VoiD7965/Station_Meteo_pcb/Station_Meteo_pcb.kicad_pcb

## KiCad design Station_Meteo_pcb.kicad_pcb (2026-05-05)

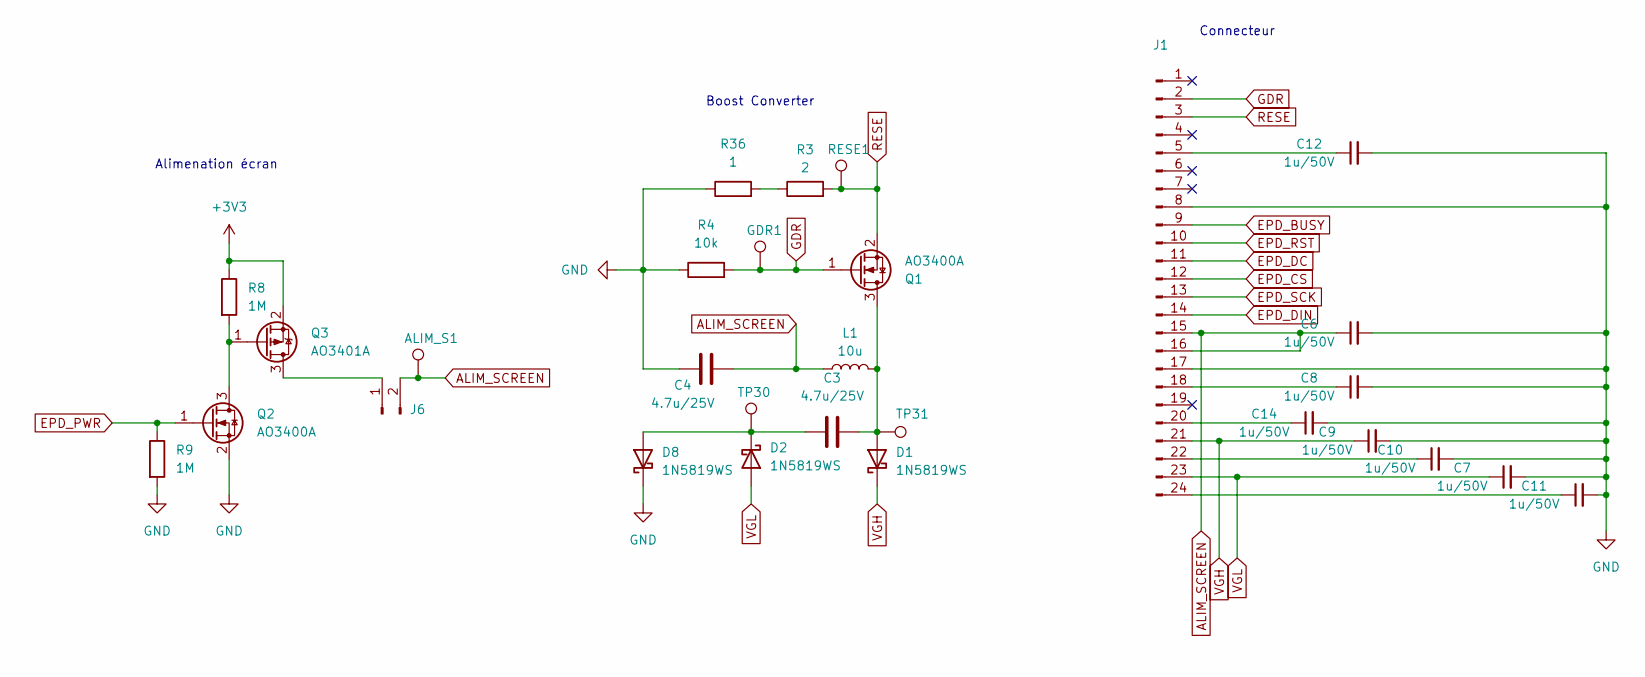
[picture p1: schematic Ecran.kicad_sch]

Parts:
ALIM_S1: TestPoint; TestPoint_Pad_D1.5mm
C3, C4: 4.7u/25V; C_0805_2012Metric; LCSC C1779
C6, C7, C8, C9, C10, C11, C12, C14: 1u/50V; C_0603_1608Metric; LCSC C15849
D1, D2, D8: 1N5819WS; D_SOD-323; LCSC C191023
GDR1: TestPoint; TestPoint_Pad_D1.5mm
J1: ZX-FPC-FWSX0.5PH224; Connector_1x24_epaper; LCSC C7419878
J6: DZ254S-11-02-48; PinHeader_1x02_P2.54mm_Vertical_SMD_Pin1Left; LCSC C5160785
L1: 10u; L_0805_2012Metric; LCSC C1046
Q1, Q2: AO3400A; SOT-23; LCSC C20917
Q3: AO3401A; SOT-23; LCSC C15127
R3: 2; R_0603_1608Metric; LCSC C22977
R4: 10k; R_0603_1608Metric; LCSC C25804
R8, R9: 1M; R_0603_1608Metric; LCSC C22935
R36: 1; R_0603_1608Metric; LCSC C22936
RESE1: TestPoint; TestPoint_Pad_D1.5mm
TP30, TP31: TestPoint; TestPoint_Pad_D1.5mm

Connections:
+3V3: Q3.2 (S), R8.1; also elsewhere on the board
ALIM_SCREEN: ALIM_S1.1, C4.2, C6.1, J1.15, J1.16, J6.2, L1.1
EPD_BUSY: J1.9; also elsewhere on the board
EPD_CS: J1.12; also elsewhere on the board
EPD_DC: J1.11; also elsewhere on the board
EPD_DIN: J1.14; also elsewhere on the board
EPD_PWR: Q2.1 (G), R9.1; also elsewhere on the board
EPD_RST: J1.10; also elsewhere on the board
EPD_SCK: J1.13; also elsewhere on the board
GDR: GDR1.1, J1.2, Q1.1 (G), R4.2
GND: C4.1, C6.2, C7.2, C8.2, C9.2, C10.2, C11.2, C12.2, C14.2, D8.1 (K), J1.8, J1.17, Q2.2 (S), R4.1, R9.2, R36.1; also elsewhere on the board
unnamed: C3.2, D1.2 (A), L1.2, Q1.3 (D), TP31.1
unnamed: C3.1, D2.1 (K), D8.2 (A), TP30.1
unnamed: C12.1, J1.5
unnamed: C8.1, J1.18
unnamed: C14.1, J1.20
unnamed: C10.1, J1.22
unnamed: C11.1, J1.24
unnamed: J6.1, Q3.3 (D)
unnamed: Q2.3 (D), Q3.1 (G), R8.2
unnamed: R3.1, R36.2
RESE: J1.3, Q1.2 (S), R3.2, RESE1.1
VGH: C9.1, D1.1 (K), J1.21
VGL: C7.1, D2.2 (A), J1.23

Notes on the sheet:
Alimenation écran
Boost Converter
Connecteur

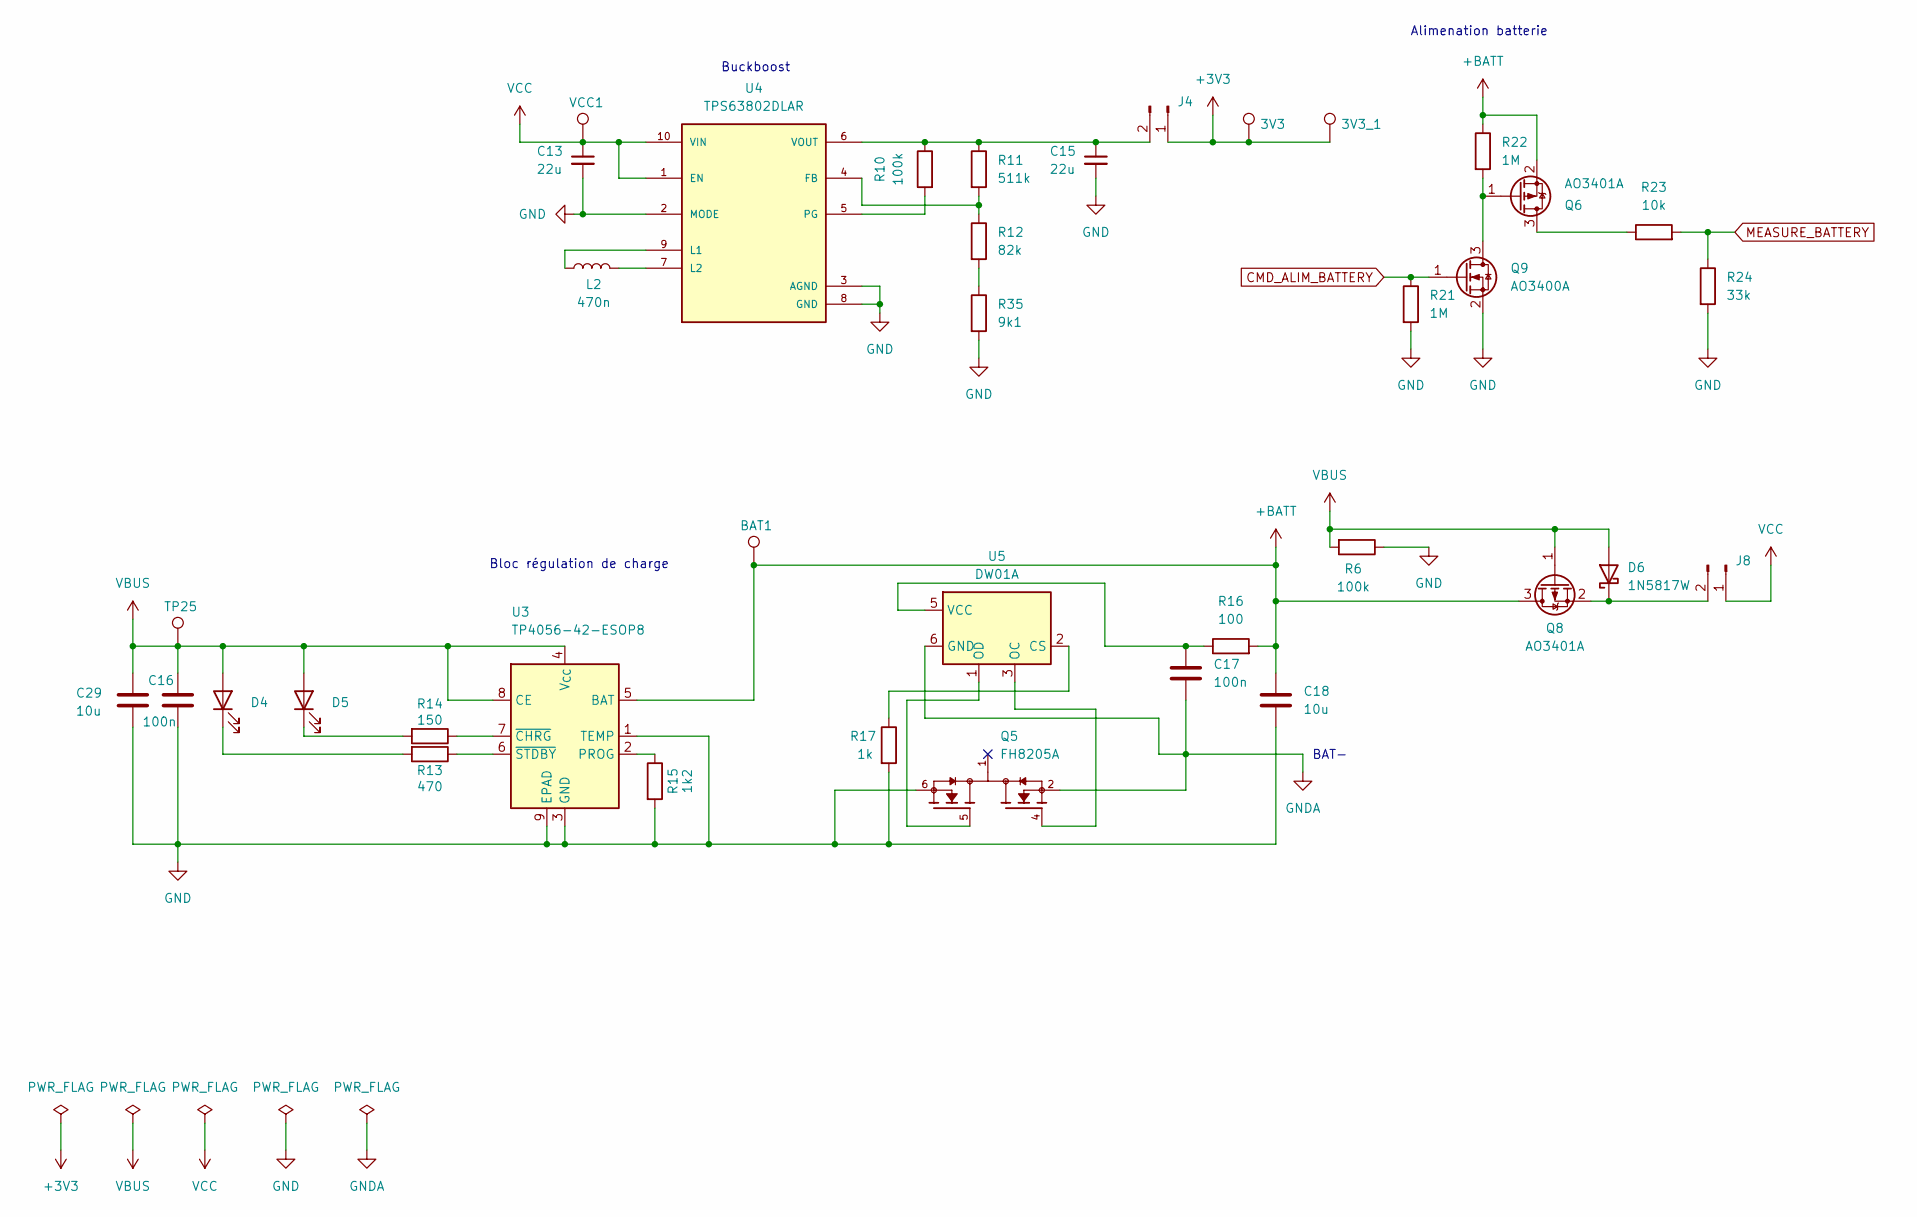
[picture p2: schematic Alimentation.kicad_sch]

Parts:
3V3, 3V3_1: TestPoint; TestPoint_Pad_D1.5mm
BAT1: TestPoint; TestPoint_Pad_D1.5mm
C13, C15: 22u; C_0603_1608Metric; LCSC C59461
C16, C17: 100n; C_0402_1005Metric; LCSC C1525
C18, C29: 10u; C_0603_1608Metric; LCSC C19702
D4: KT-0603W; LED_0603_1608Metric; LCSC C2290
D5: KT-0603R; LED_0603_1608Metric; LCSC C2286
D6: 1N5817W; D_SOD-123; LCSC C5185908
J4, J8: DZ254S-11-02-48; PinHeader_1x02_P2.54mm_Vertical_SMD_Pin1Left; LCSC C5160785
L2: 470n; SPM4030T-R47M-HZ; LCSC C531455
Q5: FH8205A; FS8205A; PARTREV 1.7; LCSC C2929075
Q6, Q8: AO3401A; SOT-23; LCSC C15127
Q9: AO3400A; SOT-23; LCSC C20917
R6, R10: 100k; R_0603_1608Metric; LCSC C25803
R11: 511k; R_0603_1608Metric; LCSC C23192
R12: 82k; R_0603_1608Metric; LCSC C23254
R13: 470; R_0603_1608Metric; LCSC C23179
R14: 150; R_0603_1608Metric; LCSC C22808
R15: 1k2; R_0603_1608Metric; LCSC C22765
R16: 100; R_0603_1608Metric; LCSC C22775
R17: 1k; R_0603_1608Metric; LCSC C21190
R21, R22: 1M; R_0603_1608Metric; LCSC C22935
R23: 10k; R_0603_1608Metric; LCSC C25804
R24: 33k; R_0603_1608Metric; LCSC C4216
R35: 9k1; R_0603_1608Metric; LCSC C23260
TP25: TestPoint; TestPoint_Pad_D1.5mm
U3: TP4056-42-ESOP8; SOIC-8-1EP_3.9x4.9mm_P1.27mm_EP2.41x3.3mm_ThermalVias; LCSC C16581
U4: TPS63802DLAR; VREG_TPS63802DLAR; PARTREV B; LCSC C2845237
U5: DW01A; SOT-23-6; LCSC C42380662
VCC1: TestPoint; TestPoint_Pad_D1.5mm

Connections:
+3V3: 3V3.1, 3V3_1.1, J4.1; also elsewhere on the board
+BATT: BAT1.1, C18.1, Q6.2 (S), Q8.3 (D), R16.2, R22.1, U3.5 (BAT); also elsewhere on the board
CMD_ALIM_BATTERY: Q9.1 (G), R21.1; also elsewhere on the board
GND: C13.2, C15.2, C16.2, C18.2, C29.1, Q5.6, Q5.7, Q9.2 (S), R6.1, R15.2, R17.2, R21.2, R24.2, R35.2, U3.1 (TEMP), U3.3 (GND), U3.9 (EPAD), U4.2 (MODE), U4.3 (AGND), U4.8 (GND); also elsewhere on the board
GNDA: C17.2, Q5.2, Q5.3, U5.6 (GND); also elsewhere on the board
MEASURE_BATTERY: R23.2, R24.1; also elsewhere on the board
unnamed: D4.1 (K), R13.2
unnamed: D5.1 (K), R14.2
unnamed: D6.1 (K), J8.2, Q8.2 (S)
unnamed: C15.1, J4.2, R10.1, R11.1, U4.6 (VOUT)
unnamed: Q6.3 (D), R23.1
unnamed: Q6.1 (G), Q9.3 (D), R22.2
unnamed: R12.2, R35.1
unnamed: R15.1, U3.2 (PROG)
unnamed: R14.1, U3.7 (~CHRG)
unnamed: R13.1, U3.6 (~STDBY)
unnamed: R11.2, R12.1, U4.4 (FB)
unnamed: L2.1, U4.9 (L1)
unnamed: L2.2, U4.7 (L2)
unnamed: R10.2, U4.5 (PG)
unnamed: R17.1, U5.2 (CS)
unnamed: Q5.4, U5.3 (OC)
unnamed: Q5.5, U5.1 (OD)
unnamed: C17.1, R16.1, U5.5 (VCC)
VBUS: C16.1, C29.2, D4.2 (A), D5.2 (A), D6.2 (A), Q8.1 (G), R6.2, TP25.1, U3.4 (V_{CC}), U3.8 (CE); also elsewhere on the board
VCC: C13.1, J8.1, U4.1 (EN), U4.10 (VIN), VCC1.1

Notes on the sheet:
BAT-
Alimenation batterie
Buckboost
Bloc régulation de charge

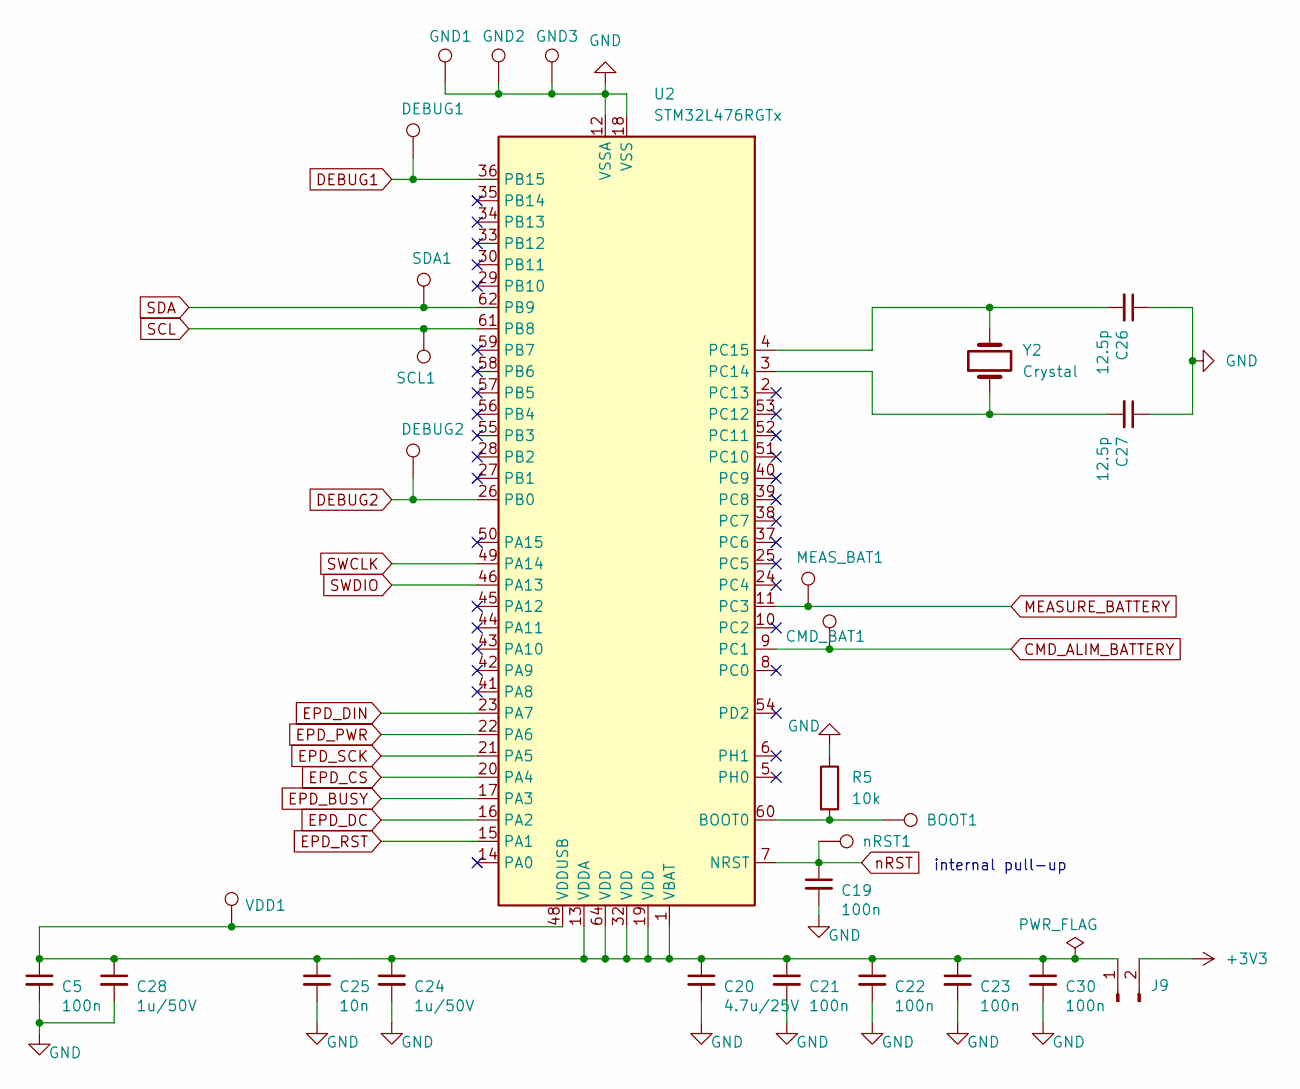
[picture p3: schematic MCU.kicad_sch]

Parts:
BOOT1: TestPoint; TestPoint_Pad_D1.5mm
C5, C19, C21, C22, C23, C30: 100n; C_0402_1005Metric; LCSC C1525
C20: 4.7u/25V; C_0805_2012Metric; LCSC C1779
C24, C28: 1u/50V; C_0603_1608Metric; LCSC C15849
C25: 10n; C_0603_1608Metric; LCSC C57112
C26, C27: 12.5p; C_0402_1005Metric; LCSC C1547
CMD_BAT1: TestPoint; TestPoint_Pad_D1.5mm
DEBUG1, DEBUG2: TestPoint; TestPoint_Pad_D1.5mm
GND1, GND2, GND3: TestPoint; TestPoint_Pad_D1.5mm
J9: DZ254S-11-02-48; PinHeader_1x02_P2.54mm_Vertical_SMD_Pin1Left; LCSC C5160785
MEAS_BAT1: TestPoint; TestPoint_Pad_D1.5mm
R5: 10k; R_0603_1608Metric; LCSC C25804
SCL1: TestPoint; TestPoint_Pad_D1.5mm
SDA1: TestPoint; TestPoint_Pad_D1.5mm
U2: STM32L476RGTx; LQFP-64_10x10mm_P0.5mm; LCSC C74797
VDD1: TestPoint; TestPoint_Pad_D1.5mm
Y2: Crystal; Crystal_SMD_3215-2Pin_3.2x1.5mm; LCSC C2450907
nRST1: TestPoint; TestPoint_Pad_D1.5mm

Connections:
+3V3: J9.2; also elsewhere on the board
CMD_ALIM_BATTERY: CMD_BAT1.1, U2.9 (PC1); also elsewhere on the board
DEBUG1: DEBUG1.1, U2.36 (PB15)
DEBUG2: DEBUG2.1, U2.26 (PB0)
EPD_BUSY: U2.17 (PA3); also elsewhere on the board
EPD_CS: U2.20 (PA4); also elsewhere on the board
EPD_DC: U2.16 (PA2); also elsewhere on the board
EPD_DIN: U2.23 (PA7); also elsewhere on the board
EPD_PWR: U2.22 (PA6); also elsewhere on the board
EPD_RST: U2.15 (PA1); also elsewhere on the board
EPD_SCK: U2.21 (PA5); also elsewhere on the board
GND: C5.2, C19.2, C20.2, C21.2, C22.2, C23.2, C24.2, C25.2, C26.1, C27.1, C28.2, C30.2, GND1.1, GND2.1, GND3.1, R5.1, U2.12 (VSSA), U2.18 (VSS), U2.31 (VSS), U2.47 (VSS), U2.63 (VSS); also elsewhere on the board
MEASURE_BATTERY: MEAS_BAT1.1, U2.11 (PC3); also elsewhere on the board
unnamed: C5.1, C20.1, C21.1, C22.1, C23.1, C24.1, C25.1, C28.1, C30.1, J9.1, U2.1 (VBAT), U2.13 (VDDA), U2.19 (VDD), U2.32 (VDD), U2.48 (VDDUSB), U2.64 (VDD), VDD1.1
unnamed: BOOT1.1, R5.2, U2.60 (BOOT0)
unnamed: C27.2, U2.3 (PC14), Y2.1
unnamed: C26.2, U2.4 (PC15), Y2.2
SCL: SCL1.1, U2.61 (PB8); also elsewhere on the board
SDA: SDA1.1, U2.62 (PB9); also elsewhere on the board
SWCLK: U2.49 (PA14); also elsewhere on the board
SWDIO: U2.46 (PA13); also elsewhere on the board
nRST: C19.1, U2.7 (NRST), nRST1.1; also elsewhere on the board

Notes on the sheet:
internal pull-up

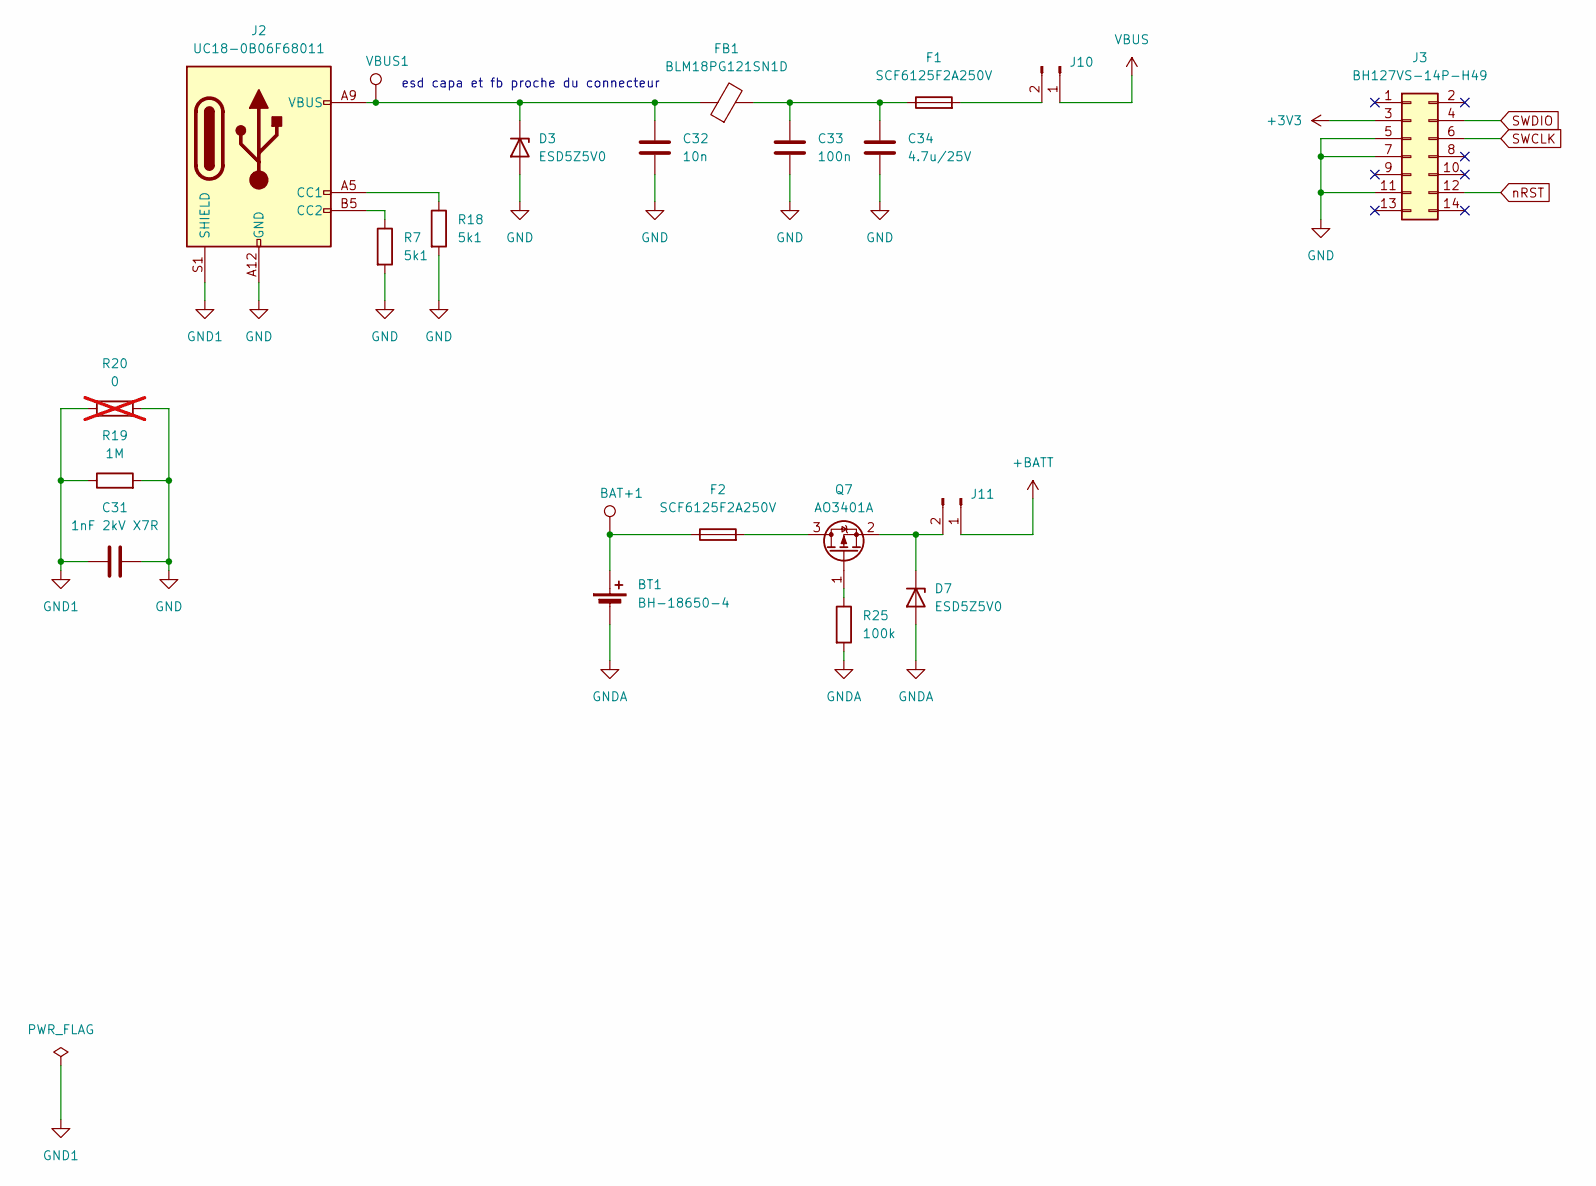
[picture p4: schematic Connecteurs.kicad_sch]

Parts:
BAT+1: TestPoint; TestPoint_Pad_D1.5mm
BT1: BH-18650-4; LCSC C7525438
C31: 1nF 2kV X7R; C_1206_3216Metric; LCSC C9196
C32: 10n; C_0603_1608Metric; LCSC C57112
C33: 100n; C_0402_1005Metric; LCSC C1525
C34: 4.7u/25V; C_0805_2012Metric; LCSC C1779
D3, D7: ESD5Z5V0; D_SOD-523; LCSC C21714169
F1, F2: SCF6125F2A250V; LCSC C19712554
FB1: BLM18PG121SN1D; L_0603_1608Metric; LCSC C14709
J2: UC18-0B06F68011; LCSC C36936555
J3: BH127VS-14P-H49; Connector_STLINKV3_Minie_14P; LCSC C42462827
J10, J11: DZ254S-11-02-48; PinHeader_1x02_P2.54mm_Vertical_SMD_Pin1Left; LCSC C5160785
Q7: AO3401A; SOT-23; LCSC C15127
R7, R18: 5k1; R_0603_1608Metric; LCSC C23186
R19: 1M; R_0603_1608Metric; LCSC C22935
R20: 0; R_0603_1608Metric; not fitted
R25: 100k; R_0603_1608Metric; LCSC C25803
VBUS1: TestPoint; TestPoint_Pad_D1.5mm

Connections:
+3V3: J3.3; also elsewhere on the board
+BATT: J11.1; also elsewhere on the board
GND: C31.2, C32.2, C33.2, C34.2, D3.2 (A), J2.A12 (GND), J2.B12 (GND), J3.5, J3.7, J3.11, R7.2, R18.2, R19.2, R20.2; also elsewhere on the board
GND1: C31.1, J2.S1 (SHIELD), R19.1, R20.1
GNDA: BT1.2 (-), D7.2 (A), R25.2; also elsewhere on the board
unnamed: BAT+1.1, BT1.1 (+), F2.1
unnamed: C33.1, C34.1, F1.1, FB1.2
unnamed: C32.1, D3.1 (K), FB1.1, J2.A9 (VBUS), J2.B9 (VBUS), VBUS1.1
unnamed: D7.1 (K), J11.2, Q7.2 (S)
unnamed: J2.A5 (CC1), R18.1
unnamed: J2.B5 (CC2), R7.1
unnamed: F1.2, J10.2
unnamed: F2.2, Q7.3 (D)
unnamed: Q7.1 (G), R25.1
SWCLK: J3.6; also elsewhere on the board
SWDIO: J3.4; also elsewhere on the board
VBUS: J10.1; also elsewhere on the board
nRST: J3.12; also elsewhere on the board

Notes on the sheet:
esd capa et fb proche du connecteur

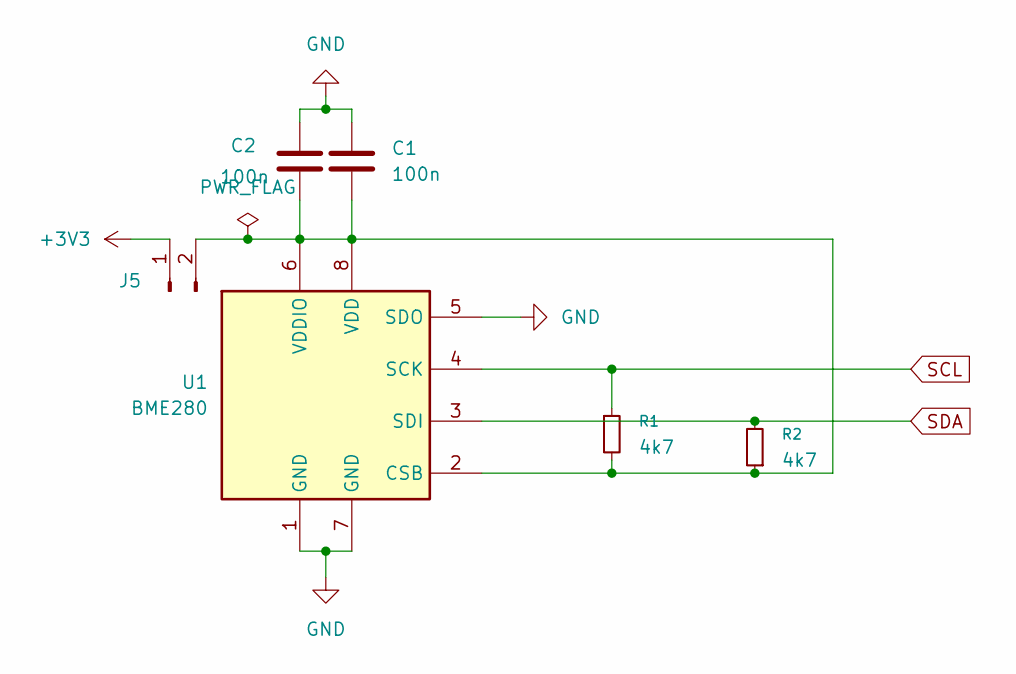
[picture p5: schematic Capteurs.kicad_sch]

Parts:
C1, C2: 100n; C_0402_1005Metric; LCSC C1525
J5: DZ254S-11-02-48; PinHeader_1x02_P2.54mm_Vertical_SMD_Pin1Left; LCSC C5160785
R1, R2: 4k7; R_0603_1608Metric; LCSC C23162
U1: BME280; Bosch_LGA-8_2.5x2.5mm_P0.65mm_ClockwisePinNumbering; LCSC C92489

Connections:
+3V3: J5.1; also elsewhere on the board
GND: C1.2, C2.1, U1.1 (GND), U1.5 (SDO), U1.7 (GND); also elsewhere on the board
unnamed: C1.1, C2.2, J5.2, R1.2, R2.1, U1.2 (CSB), U1.6 (VDDIO), U1.8 (VDD)
SCL: R1.1, U1.4 (SCK); also elsewhere on the board
SDA: R2.2, U1.3 (SDI); also elsewhere on the board

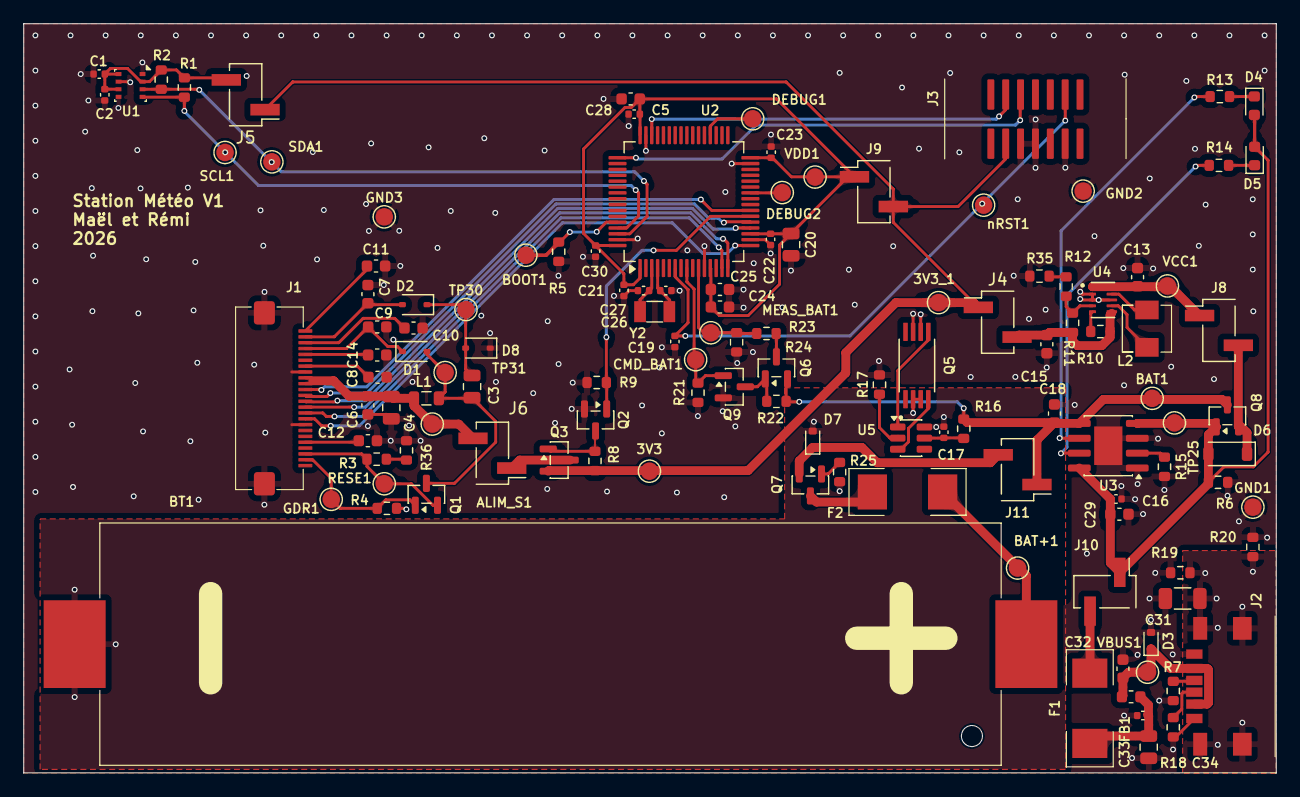
[picture p6: board Station_Meteo_pcb.kicad_pcb from above]

Board: 2 copper layers, 107.0 x 64.0 mm, 123 parts (0 on the bottom side), 70 nets.
