VoiD7965/Station_Meteo_pcb/(commit log)

2026-03-22 first push
    [Station_Meteo_pcb.kicad_pcb, Station_Meteo_pcb.kicad_sch]
2026-03-22 Schematique Capteurs
    Mise en forme des pages pour les différents schémas kicad
    Pages capteurs mais à vérifier
    [Alimentation.kicad_sch, Capteurs.kicad_sch, Debug.kicad_sch, Ecran.kicad_sch, MCU.kicad_sch, Station_Meteo_pcb.kicad_sch]
2026-03-23 Test ajout de composant depuis l'internet
    [Ecran.kicad_sch]
2026-03-23 Correction capteur + ajout composant
    Il fallait changer le nom dans le gestionnaire de footprint
    Correction de la connectique du capteur, mais à vérifier quand même
    [Capteurs.kicad_sch, Ecran.kicad_sch]
2026-03-23 Partie écran
    [Alimentation.kicad_sch, Ecran.kicad_sch, MCU.kicad_sch]
2026-03-23 Début de la partie alimentation
    [Alimentation.kicad_sch]
2026-03-24 Ajout total de la partie alimentation
    Ajout de composant depuis un site internet ->OK
    Fin de la partie écran et alimentation : ajout de tous les composants
    [Alimentation.kicad_sch, Ecran.kicad_sch, MCU.kicad_sch, Station_Meteo_pcb.kicad_pcb]
2026-03-25 Début Debug + MAJ MCU
    [Debug.kicad_sch, MCU.kicad_sch]
2026-03-31 Dernieres pour review
    [Alimentation.kicad_sch, Capteurs.kicad_sch, Debug.kicad_sch, Ecran.kicad_sch, MCU.kicad_sch]
2026-04-02 revue schema
    [Alimentation.kicad_sch, Capteurs.kicad_sch, Debug.kicad_sch, Ecran.kicad_sch, MCU.kicad_sch]
2026-04-04 premieres modif depuis la review
    [Alimentation.kicad_sch, Capteurs.kicad_sch, Connecteurs.kicad_sch, Debug.kicad_sch, Ecran.kicad_sch, MCU.kicad_sch, Station_Meteo_pcb.kicad_sch]
2026-04-05 schema v1
    [Alimentation.kicad_sch, Capteurs.kicad_sch, Connecteurs.kicad_sch, Ecran.kicad_sch, MCU.kicad_sch]
2026-04-05 shema v1
    [Debug.kicad_sch]
2026-04-10 Connecteurs + sourcing
    [Alimentation.kicad_sch, Capteurs.kicad_sch, Connecteurs.kicad_sch, Ecran.kicad_sch, MCU.kicad_sch, bom.csv, designators.csv, positions.csv]
2026-04-23 push routage
    [Station_Meteo_pcb.kicad_pcb]
2026-04-24 Suite routage (vers pile)
    [Station_Meteo_pcb.kicad_pcb]
2026-04-24 V1 Placement + Routage
    [Connecteurs.kicad_sch, Station_Meteo_pcb.kicad_pcb]
2026-04-26 TEST POINT
    [Station_Meteo_pcb.kicad_pcb]
2026-04-27 Placement + routage V2
    [Alimentation.kicad_sch, Connecteurs.kicad_sch, Ecran.kicad_sch, MCU.kicad_sch, Station_Meteo_pcb.kicad_pcb]
2026-04-27 Correction des erreurs (DRC)
    [Connecteurs.kicad_sch, Station_Meteo_pcb.kicad_pcb]
2026-04-27 Suite DRC
    [Ecran.kicad_sch, Station_Meteo_pcb.kicad_pcb]
2026-04-28 Placement + routage V3
    [MCU.kicad_sch, Station_Meteo_pcb.kicad_pcb]
2026-05-05 modif pour commande
    [Alimentation.kicad_sch, Capteurs.kicad_sch, Ecran.kicad_sch, MCU.kicad_sch, Station_Meteo_pcb.kicad_pcb, Station_Meteo_pcb.kicad_pcb_bom.csv, Station_Meteo_pcb.kicad_pcb_positions.csv, bom.csv]
2026-05-05 last push
    [Connecteurs.kicad_sch, Station_Meteo_pcb.kicad_pcb]
2026-05-05 last p
    [Alimentation.kicad_sch, Station_Meteo_pcb.kicad_pcb]
2026-05-17 Commande PCB finale
    [Station_Meteo_pcb.kicad_pcb_bom.csv, Station_Meteo_pcb.kicad_pcb_positions.csv, bom.csv]
